owen8900/enclosure-watchdog/images/fig1_architecture.png

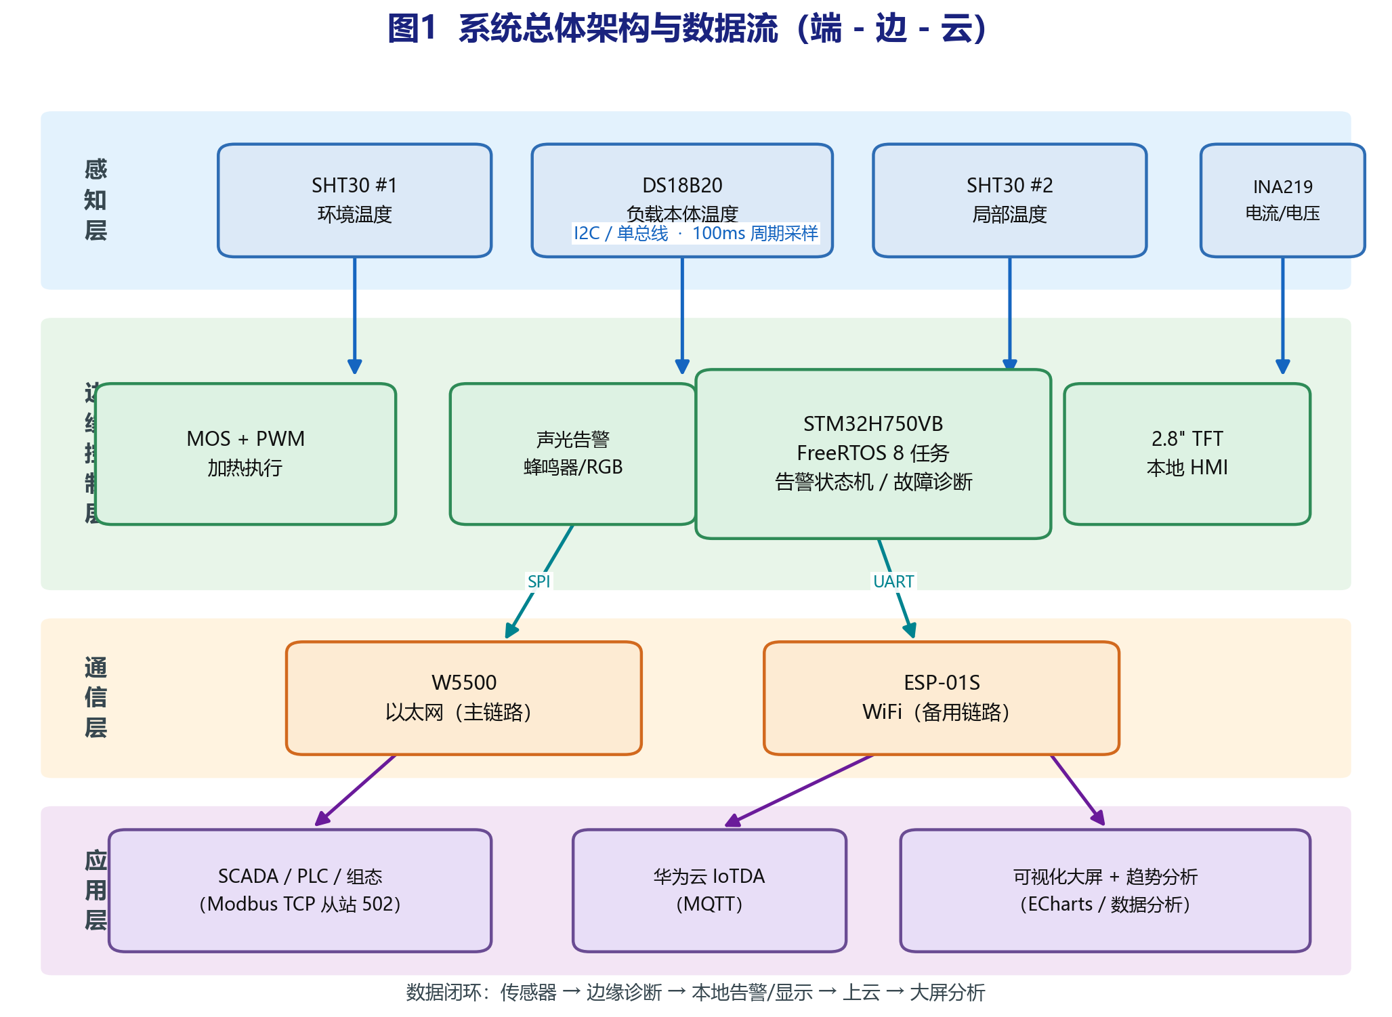
images/fig1_architecture.png
