owen8900/enclosure-watchdog/images/fig2_hardware.png

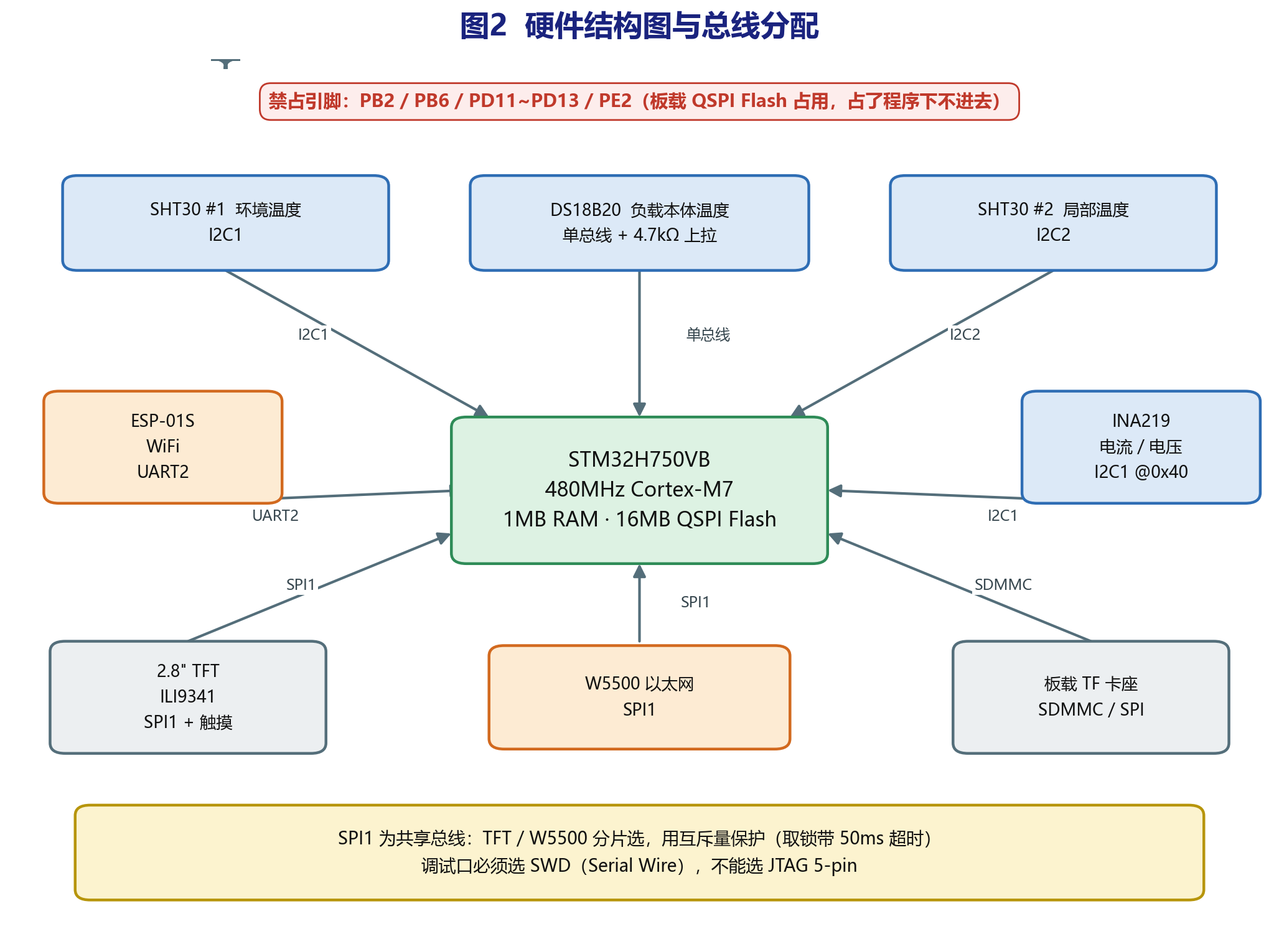
images/fig2_hardware.png
