owen8900/enclosure-watchdog/images/fig3_power.png

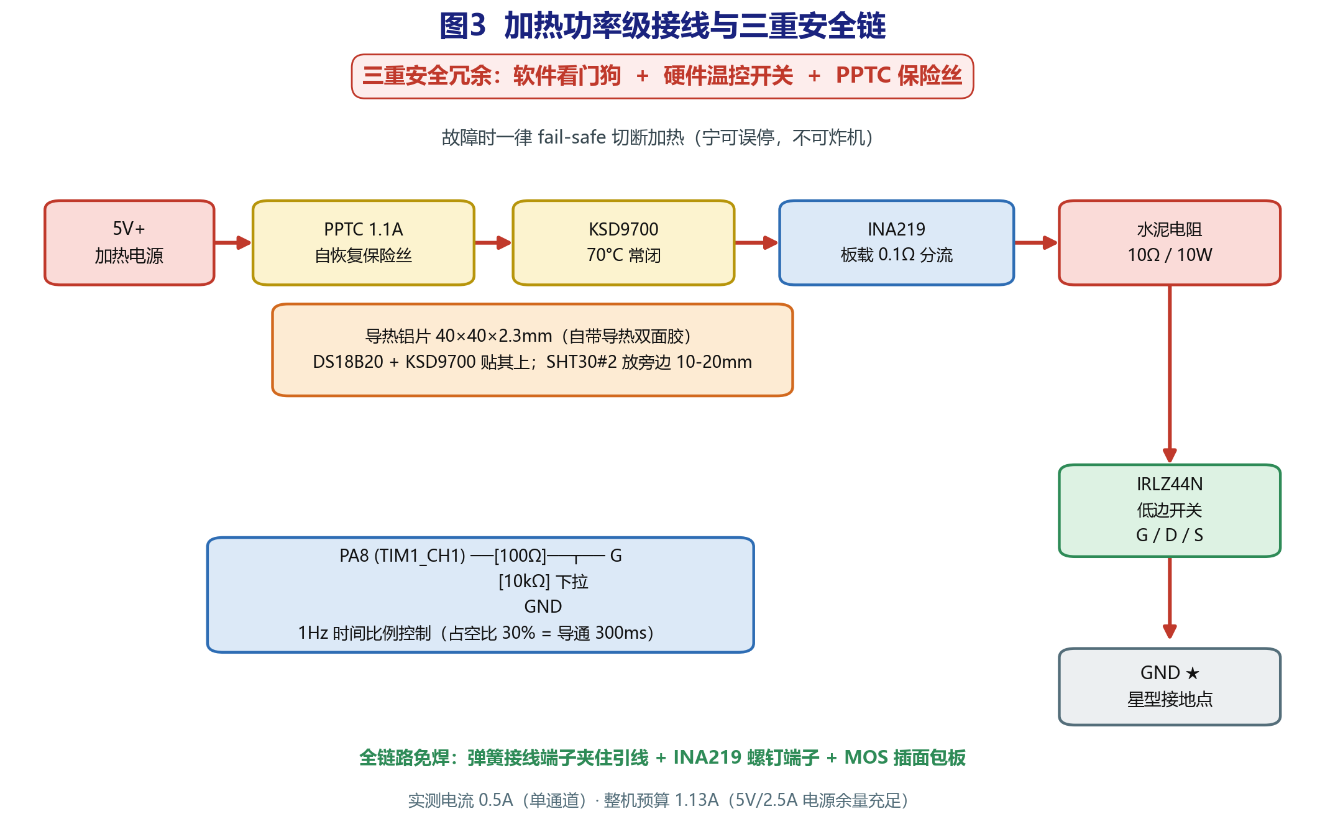
images/fig3_power.png
