owen8900/enclosure-watchdog/images/fig6_statemachine.png

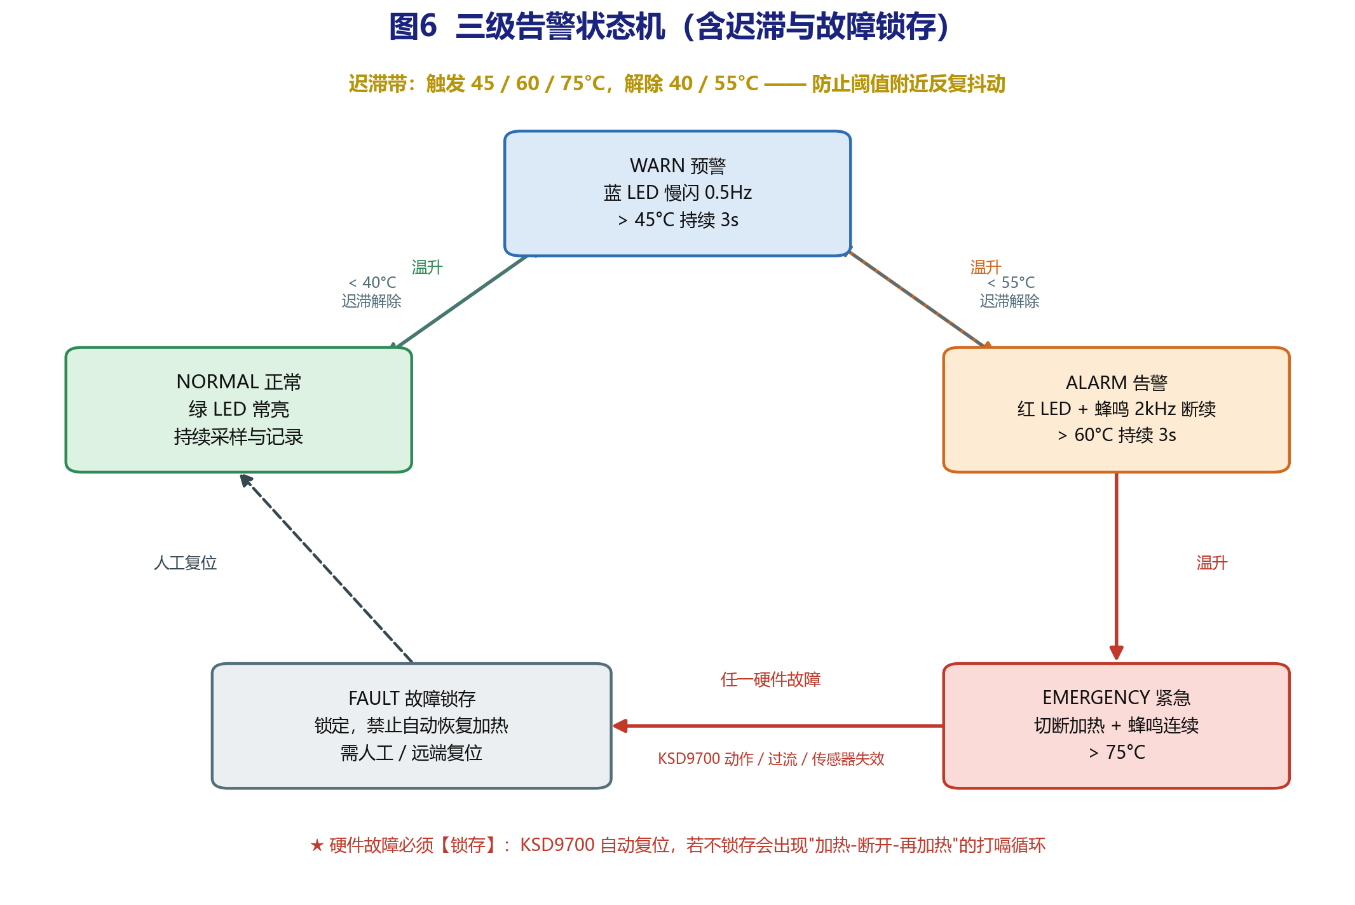
images/fig6_statemachine.png
