owen8900/enclosure-watchdog/images/fig12_integration.png

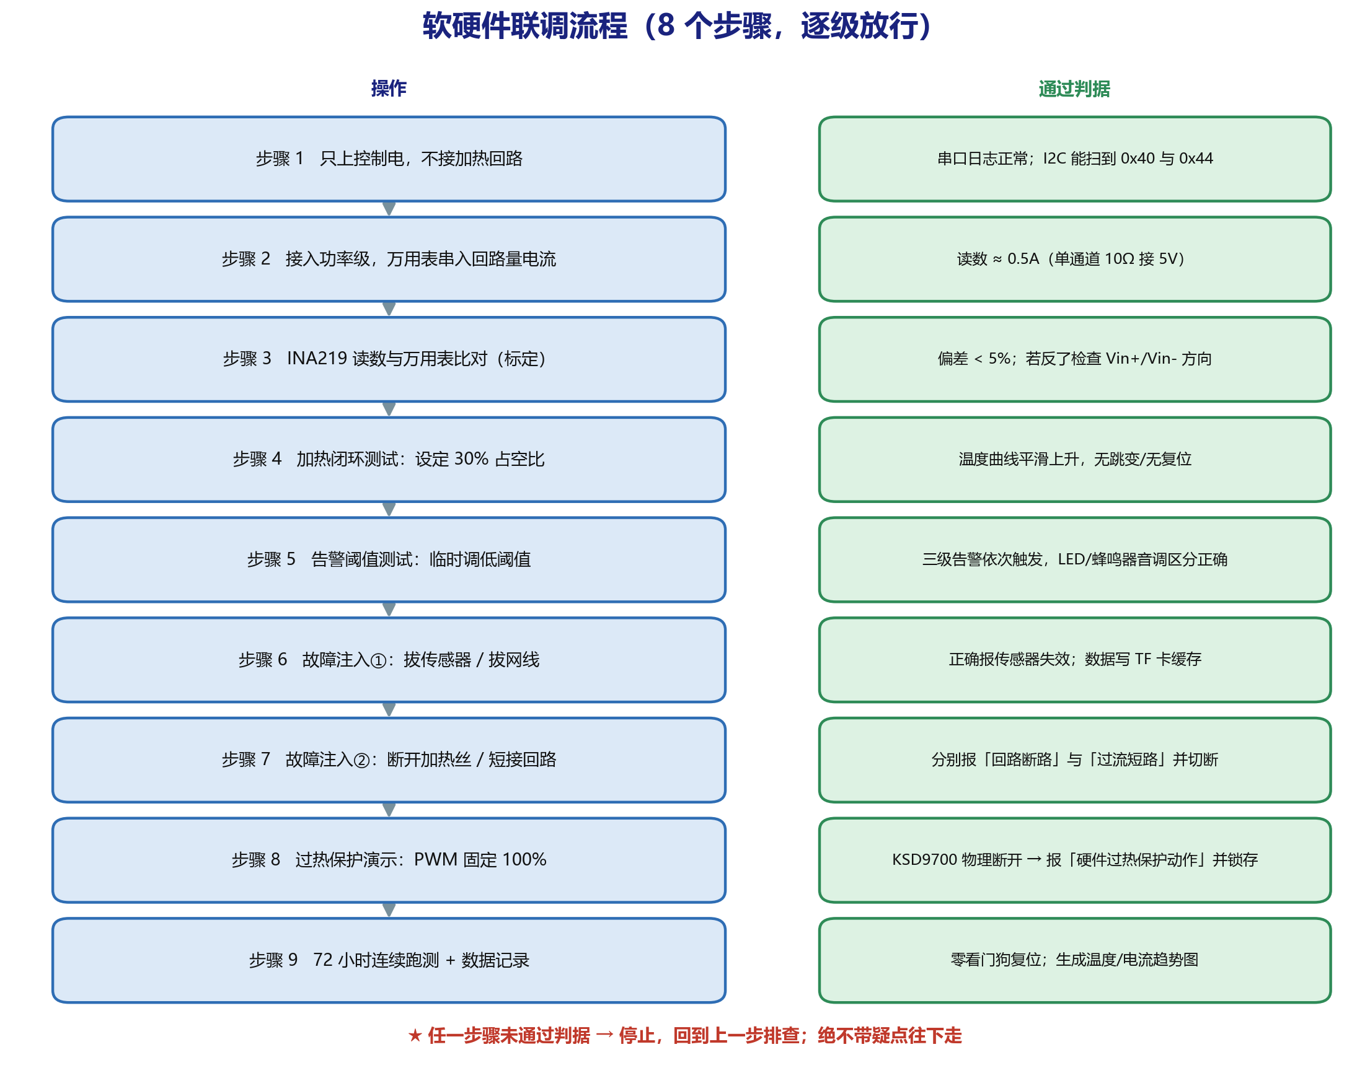
images/fig12_integration.png
