owen8900/enclosure-watchdog/images/fig4_steps.png

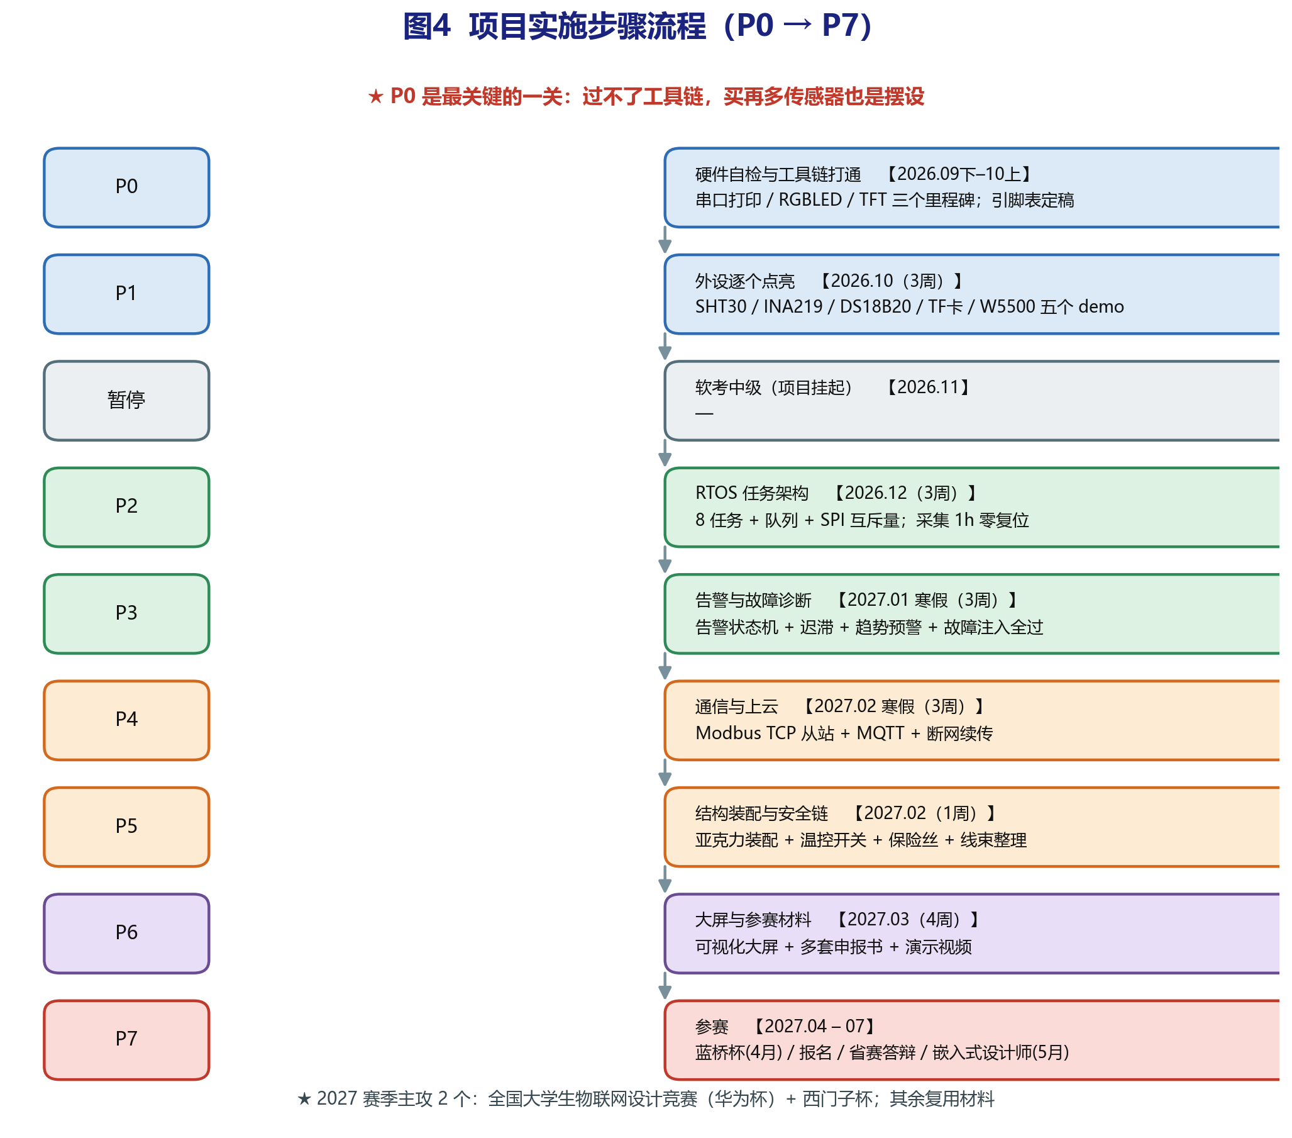
images/fig4_steps.png
