owen8900/enclosure-watchdog/code/Core/Inc/main.h

#define LED_B_Pin GPIO_PIN_5
#define LED_B_GPIO_Port GPIOE
#define LED_G_Pin GPIO_PIN_6
#define LED_G_GPIO_Port GPIOE
#define TOUCH_DO_Pin GPIO_PIN_0
#define TOUCH_DO_GPIO_Port GPIOC
#define TOUCH_CS_Pin GPIO_PIN_3
#define TOUCH_CS_GPIO_Port GPIOC
#define TOUCH_DIN_Pin GPIO_PIN_3
#define TOUCH_DIN_GPIO_Port GPIOA
#define TFT_CS_Pin GPIO_PIN_12
#define TFT_CS_GPIO_Port GPIOB
#define TOUCH_CLK_Pin GPIO_PIN_14
#define TOUCH_CLK_GPIO_Port GPIOB
#define LED_R_Pin GPIO_PIN_4
#define LED_R_GPIO_Port GPIOB
#define TFT_RST_Pin GPIO_PIN_0
#define TFT_RST_GPIO_Port GPIOE
#define TFT_DC_Pin GPIO_PIN_1
#define TFT_DC_GPIO_Port GPIOE
