owen8900/enclosure-watchdog/(commit log)

2026-09-13 初始提交：项目文档、硬件方案与核心算法（PC 端测试 11/11 通过）
2026-09-13 移除文档排版脚本
    这些脚本用来生成 Word 排版文档，不属于项目本体，生成的文档也已移出仓库。
    脚本本身保留在本地 notes/ 目录下，不入版本控制。
2026-09-13 图片改为中文命名，并挂载到对应文档
    原来的 fig1_architecture.png 这类命名不符合阅读习惯。
    改成按内容命名，例如 系统架构图.png、接线总览图.png，
    并在 README 和各篇设计文档里引用，避免图片成为无引用的孤儿文件。
2026-09-13 按开发板实测引脚分配表修正引脚方案
    之前是根据推导排的，拿到正点原子官方《MiniPro H750 V1 开发板 IO 引脚分配表》
    后逐条核对，改了八处：
    - 板载 I2C 从 PB8/PB9 改为 PB10/PB11（24C02 挂在这里，已有 4.7k 上拉）
    - DS18B20 改为 PC13（板载单总线接口，上拉已焊）
    - ESP-01S 从 PD5/PD6 改为 USART6 的 PC6/PC7（PD5/PD6 被 FMC 和触摸占用）
    - TFT 背光从 PB0 改为 PB5（板载 LCD 接口的 BL 脚）
    - 触摸片选从 PB1 改为 PC5，中断改为 PB1
    - 告警 LED 从 PC13 改为 PB12（PC13 让给 DS18B20）
    - QSPI 数据线更正：PD13 是 IO3，IO2 在 PE2
    引脚表加了「依据」一列，注明每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
2026-09-14 修正 RGB 灯引脚标注错误
    跑马灯例程 readme 和开发板 IO 引脚分配表都写明：
    RED(PB4) / GREEN(PE6) / BLUE(PE5)
    此前文档里写成了 绿=PE5、蓝=PE6，两色对调。
    共修正 9 个文件 12 处。
2026-09-14 按实测引脚分配表重绘接线总览图与引脚占用图
    出图脚本里的引脚数据和最新引脚表几乎全对不上，一并修正：
    - SHT30#1/INA219 由 PB8/PB9 改为 PB10/PB11（板载 I2C2，上拉已焊）
    - SHT30#2 由 PB10/PB11 改为 PB8/PB9（独立 I2C1）
    - DS18B20 由 PB12 改为 PC13（板载单总线接口）
    - ESP-01S 由 PD5/PD6 改为 PC6/PC7（USART6）
    - TFT 背光由 PB0 改为 PB5
    - 触摸 CS/IRQ 由 PB1/PC5 对调为 PC5/PB1
    - 告警 LED 由 PC13 改为 PB12
    - QSPI 数据线更正 PD13=IO3、PE2=IO2
    同时修复出图脚本的路径 bug：脚本位于 notes/tools/ 距仓库根两层，
    dirname 只用了两层，导致图片写到了 notes/images/ 而非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
2026-09-14 完成 P0a：CubeMX 工程生成 + 串口/GPIO 固件在板上跑通
    硬件：正点原子 MiniPro STM32H750 V1.5（片内 Flash 仅 128KB）
    工具链：Keil MDK 5.36 + STM32CubeMX 6.3.0 + 串口下载（无 ST-Link）
    分工：
    code/App/ 硬件无关的逻辑层（之前已完成，PC 端可测）
    code/Core/ CubeMX 生成 + 手写外设初始化与主循环
    code/Drivers/ HAL 驱动与 CMSIS
    code/MDK-ARM/ Keil 工程
    已实现的配置：
    时钟 HSE 8MHz -> PLL(M=4,N=480,P=2) -> SYSCLK 480MHz，VOS0
    AXI 240MHz / APB1-4 120MHz / APB 定时器时钟 240MHz
    串口 USART1 走 PA9/PA10，115200 8N1，接板载 CH340C
    灯 PB4/PE6/PE5 = RGB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
2026-09-14 完成 P0a-2：SDMMC1 挂载 SD 卡在板上跑通（SanDisk 16GB，实测 15193 MB）
    时钟（本次唯一改动的时钟树）：
    DIVQ1 由 /2 改 /5 -> PLL1Q 192MHz
    原因：PLL1Q 原为 480MHz，而 HAL 在识别卡时用的是编译时常数
    SDMMC_INIT_CLK_DIV=250，480/(2*250)=960kHz，超 SD 规范 400kHz 的 2.4 倍
    识别 SDMMC_CK = 192 / (2*250) = 384kHz 合规
    传输 SDMMC_CK = 192 / (2*4) = 24MHz 合规
    副作用：SPI1,2,3 内核时钟也随 PLL1Q 变为 192MHz（后续接 SPI 屏正好可用）
    外设：
    SDMMC1 四位宽总线，PC8/PC9/PC10/PC11 = D0~D3，PC12 = CK，PD2 = CMD（AF12）
    Clock Divider 填 4；不配 DMA —— H7 的 SDMMC 自带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
2026-09-14 完成 P0b-1：FATFS 挂载 SD 卡跑通（含写文件后读回比对），注释改中文
    实测输出（SanDisk 16GB，USART1 115200 8N1）：
    FATFS mount: OK
    SD card : OK type 1 (SDHC/SDXC) version 1 (SD 2.0)
    SD blockNbr: 31116288 blockSz 512 capacity 15193 MB
    SD class : 1461 (CSD 的 CCC 命令类位图，不是速度等级)
    FATFS free : 15189 MB (cluster = 64 扇区 = 32KB)
    FATFS dir : [FILE] CG_TEST.TXT
    FATFS write: 34 bytes -> CG_TEST.TXT
    FATFS read : OK, content matches (写完读回来逐字节比对一致)
    CubeMX 生成行为 —— 每次 GENERATE CODE 之后必查（已写进技能）：
    1. 使能 FATFS 后，CubeMX 把 HAL_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
2026-09-14 精简 main.c 注释：去掉装饰分隔符，压缩冗长说明
    改动内容：
    - 删掉装饰性的 /* ---- xxx ---- */ 包装，以及 /* ---- 第 N 步 ---- */ 的长破折号
    - M3 的成因说明从 15 行压到 5 行；其余注释逐条压缩到 1~2 行
    - 内联注释统一成 /* 红亮 */ 这种最小形式，不再做过对齐
    保留全部技术事实（这些是踩坑记录，删掉就白踩了）：
    - CubeMX 使能 FATFS 后会把 HAL_SD_Init() 从 MX_SDMMC1_SD_Init() 里删掉，
    卡改由 FATFS 的 BSP_SD_Init() 在首次 f_mount 时识别，所以卡信息必须挂载后再读
    - HAL_SD_GetCardInfo() 不填 CardSpeed，打印它会读到未初始化的栈内存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
2026-09-15 任务2 前半：u32_to_str + build_cycle_line 搬入 main.c，心跳行改由它们拼接（实板串口实测与改前逐字节相同，M3 自检全 OK）
2026-09-15 任务2 完成：心跳行追加写 SD 卡日志 LOG.TXT（实测每轮 +9/+10 字节 = 6+位数+2；cycle9 后 4729B、cycle10 后 4739B；开机自动 dump 文件头 200B，免读卡器验收）；打通 SWD 下载（ST-Link V2，IDCODE 0x6BA02477，BOOT0 永久留 GND）；uvprojx 被工具重排版（已核对 39 个文件一个没少、Star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
2026-09-15 更新 README：当前状态改为开发板已到位（P0a/P0b 实板验证通过）；新增硬件在环验证表；目录树按实际工程结构重写；显示选型改 2.8 寸 LCDWiki MSP2807；存储行标注轮转策略待做
2026-09-16 验证报告补上硬件在环部分，标题改为「验证报告」
    报告原先只覆盖算法层的 PC 端用例，上板之后这部分一直空着。这次把实板数据补进去：
    下载通道（串口与 SWD 两种）、上电自检的时钟实测、SD 卡与 FatFs 的完整串口输出、
    心跳日志落卡的每轮增量判据。心跳那段保留了一条对照实验——把打开模式换回
    FA_CREATE_ALWAYS，文件大小就不再随轮次累积，这条对照才是判定追加语义的依据。
    没验证的部分也一并列出：拔卡、写满、时序抗干扰。
2026-09-16 配上 SPI2 并挂好 2.8 寸 ILI9341 屏的引脚
    屏的接口定在 SPI2：PB13 时钟、PB15 数据，片选 PB12、复位 PE0、数据命令 PE1，
    三个控制脚的初始电平按"片选与复位常态高、数据命令常态低"设好。预分频取 32，
    SPI2 内核时钟 192MHz，实际 6MBits/s；Mode 0 与厂商例程一致。
    生成时还踩了一个坑：CubeMX 把 CMSIS 模板里的 startup_stm32h750xx.s 删掉了，
    Startup 组也一起消失，链接直接报 L6236E（分散加载文件里 RESET 段找不到向量表）。
    从 git 恢复该文件、把 Startup 组插回 uvprojx 之后编译通过，0 error 0 warning，
    Code=27830。
2026-09-16 接入 2.8 寸 ILI9341 SPI 屏，BSP 层驱动 + 上电刷色自检
    新增 code/Drivers/BSP/ili9341/。SPI1 的 PA5/PA6/PA7 没有引到 IO 排针上，改用 SPI2：
    信号走 PB13/PB15，片选 PB12、复位 PE0、数据命令 PE1。初始化序列照厂商 F429 例程
    的原值，只把 SPI 层换成 hspi2，寄存器值没有自己编。每次传输带 100ms 超时并累计
    失败次数，不留死等；发送缓冲 512 字节放静态区，不占栈。
    main.c 增加 M4 自检段：上电后红、绿、蓝各刷 0.4 秒，串口打印初始化状态与累计 SPI
    错误数。另外修了一起生成事故：CubeMX 这次把 main.c 里 41 行中文注释整段截断，从
    8a188c1 取回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
2026-09-16 屏不亮，加一个接线核对模式用万用表查线
    屏接上以后串口报 init OK、SPI 错误计数 0，屏却毫无反应。逐层排查：厂商例程的 SPI
    参数也是 Mode 0，spi.c 的 MspInit 里 PB13/PB15 的复用配置也对，那就只剩物理层。
    为此写了个不依赖调试器的核对模式：CS/RST/DC 依次 1Hz 翻转 8 秒，万用表直流档能
    直接看到 0V 与 3.3V 交替；SCK 与 MOSI 用持续发 0x00、0xFF 两轮区分，两轮里 SCK
    读数都约 1.6V，MOSI 则从 0V 跳到 3.3V。没有示波器也能把五根线对上。
    顺带加了日志回调：main.c 的 uart_puts 是 static，驱动调不到。核对模式由 main.c
    的 LCD_WIRING_TEST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
2026-09-16 屏点亮，关掉接线核对模式
    线的问题解决后不必每次上电都跑核对，改回 LCD_WIRING_TEST 0，省掉那 40 秒等待。
    核对函数留在驱动里，以后接触摸屏和 W5500 再碰到"SPI 报成功但设备不理人"，把宏
    打开就能用。
    本次根因是一根 SDI(MOSI) 杜邦线没插到底。数据线断了，时钟照跑、HAL 照返回 HAL_OK，
    屏收到的是乱码命令，所以串口一路正常、屏一动不动。排查过程记在 notes/13 §5.1。
2026-09-16 画控制柜面板界面，并压回 MDK-Lite 的 32KB 映像上限内
    新增 code/Drivers/BSP/lcd_font/（8x16 ASCII 字模 95 字，从厂商 FONT.H 的
    asc2_1608 原表抽出，未改动）与 code/Drivers/BSP/lcd_ui/（面板静态框架 +
    数据刷新）：标题栏、三行数值（温度/电流/电压，各带右侧状态色块）、中间一条
    总告警色条、底部状态行与自检行。数值暂用占位值，接上传感器后由调用方填入。
    ili9341 驱动补齐画线（Bresenham）、水平/垂直/空心矩形、字符与字符串绘制，
    字符支持 1~4 倍放大；越界或一行装不下就整体不画，直接返回。
    界面一进来就撞上免费版 Keil 的 3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
2026-09-16 XPT2046 触摸驱动：位翻转软件 SPI，编译通过，等上板验证
    模块上的触摸控制器和 ILI9341 本来是两条独立的 SPI（T_CLK/T_DIN/T_DO 与
    SCK/SDI/SDO 分开引出），所以没有并到 SPI2 上，而是用四条普通 GPIO 位翻转。
    理由是速率差得远：XPT2046 的 SCLK 上限约 2MHz，而 ILI9341 跑在 6MHz。合成一条
    总线的话，每读一次触摸都要先改 SPI2 分频、读完再改回来，等上 FreeRTOS 加互斥量
    时这类共享状态就是 bug 温床。位翻转只多占三个脚，互不干扰。
    引脚选的是左侧 IO 排针上、且官方 IO 分配表写「不插对应模块就完全独立」的几根：
    T_CS=PC3、T_CLK=PB14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
2026-09-16 切到 ARM Compiler 6：Community 许可不覆盖 AC5，32KB 上限随之解除
    社区版许可激活之后，工程还是链接失败，报的还是 L6047U（33512 字节超 32768）。
    查下来不是配置漏项，是许可范围问题：用户许可（User Based Licensing）只覆盖 AC6，
    AC5 用不了。三条证据：
    一、同一份超限代码，AC6 的链接器把 40978 字节的映像正常链出来（exit 0），
    AC5 的 armlink 对 41272 字节报 L6047U（exit 1）。
    二、armclang --version 自报 Product: Keil MDK Community；armcc 那边没有这句。
    三、armlm genLIC（从用户许可生成老式 LIC 的官方口子）明确拒绝，原文是
    "This license doe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
2026-09-16 屏左右镜像：MADCTL 补上 MX 位（0x08 -> 0x48）
    上板看界面时发现整屏的字是左右反的（"WARNING" 印成照镜子的样子）。
    上下方向是对的（标题栏在上面、状态行在下面），所以是纯水平镜像，不是 180° 旋转。
    MADCTL(0x36) 里有三位管方向：bit3 是 BGR 颜色顺序、bit6 是 MX（列地址反序）、
    bit7 是 MY（行地址反序）。厂商例程给的是 0x08，只开了 BGR —— 那是照他们手上
    那块玻璃的装配方向写的；我们这块实测要补 MX，也就是 0x48。初始化序列其余部分
    一个字节没动。
    顺带记一条：别顺手把 MY 也一起改，那会变成 180° 旋转，字上下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
2026-09-16 触摸标定改成「读数稳住就自己锁值」，一点一行不刷屏
    原来的自检每 200ms 打一行 raw X/Y，读数一直在跳 —— 手指在动、单次采样也有噪声，
    眼睛盯着跳数抄本来就取不准。
    改成标定向导（入口还是 xpt2046_selftest，main.c 里 XPT_SELFTEST_SECONDS 从 20
    调到 60，够点两轮）。四个点 LEFT/RIGHT/TOP/BOTTOM 依次点住：
    - 按下期间累计平均值和极值，满足任一条就捕获：
    (a) 采样 >= 6 且 X/Y 极差都 <= 48（读得干净，早捕获）
    (b) 采样 >= 16（约 800ms，多吵都捕获）
    第二条是关键：只按「稳住才捕获」的话，面板噪声一旦大于容差就永远等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
2026-09-16 标定汇总改掉一条会害人的提示：别拿空闲 X 去卡窗口
    欧文把串口日志发回来了（还是上一版的 raw X/Y 格式），数据把两件事钉死：
    一、判「按没按下」靠 Y —— 四百多行空闲记录里 Y 一直顶在 4095，一次例外都没有；
    按住时 Y 落在 245~3820。
    二、空闲时的 X 是乱跳的（178~790），而且跟「点左边」时的 X（180~230）重叠 ——
    所以 X 既不能单独用来判按下，也不能拿来卡窗口。
    原来汇总里那句「keep XPT2046_VALID_MIN/MAX outside this range」对着这种面板是错的：
    照它把窗口挤到空闲 X 范围之外，屏幕左边就被裁掉了。改成分开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
2026-09-16 触摸标定填上实测值，并加五点验收（固件自己判 PASS/FAIL）
    标定值来自点向导量的一轮。他点的是四个角（一个角同时给出 X 和 Y 的量程端点），
    每个角被独立测了两次，同一边两次相差 1~40 个数（约 1~3 像素），一致性好，取平均：
    x_raw_at_0 = 281 (左) x_raw_at_max = 3782 (右)
    y_raw_at_0 = 300 (上) y_raw_at_max = 3792 (下)
    swap_xy = 0
    顺手加了五点验收 xpt2046_verify()：点住左上、右上、左下、右下、正中，固件把原始值
    映射成像素坐标跟期望值比对，容差 12 像素，直接打 PASS/FAIL，最后给 n/5 结论。
    捕获判据跟标定向导共用（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
2026-09-16 修正标定：这块面板的 raw Y 与屏幕 Y 是反的（五点验收抓出来的）
    上一版刚填上标定值就去验收，五点里四个角全 FAIL，而且失败方式很整齐：
    [VERIFY 1/5] TOP-LEFT raw 196,3886 -> px 0,319 expect 0,0 FAIL
    [VERIFY 3/5] BOTTOM-LEFT raw 205,255 -> px 0,0 expect 0,319 FAIL
    点「左上角」映射成左下、点「左下角」映射成左上 —— 纯 Y 轴反向。
    根因是我上一轮推 Y 方向时推错了。那轮用的是 LEFT/RIGHT/TOP/BOTTOM 四点协议，
    而他四次的原始值里「TOP」和「BOTTOM」落在同一个 Y 上（3792 / 3791），
    说明那轮他没照提示点，我却按提示顺序去推上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
2026-09-16 主循环改成时间片调度，并加上触摸画点（① 验收用）
    原来主循环是整轮用 HAL_Delay 串起来的：光 RGB 三色就 0.9 秒，后面还有 SD 追加写
    和每 10 轮一次的面板刷新。手指按下去很可能正卡在延时里 —— 表现就是"触摸不灵、漏按"。
    改成每个动作各走各的周期，谁都不阻塞谁：
    LED 300ms
    触摸扫描 20ms <- 跟手的关键
    心跳日志 1000ms （原来约 0.9 秒一轮，等价）
    面板刷新 10000ms （原来每 10 轮，等价）
    顺带两件：
    - XPT_SELFTEST_SECONDS 改回 0。自检验收完了，正式固件不留这个阻塞段。
    注意：改回 0 之后两个向导（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
2026-09-16 触摸演示加原始值输出：定位"十字跟手指左右相反"到底出在哪一层
    反馈是十字跟手但左右相反。可五点验收用的是**同一套映射函数**（xpt_raw_to_px），
    方向真反了验收不可能 5/5 PASS —— 所以要么读数在这条路径上和验收路径不同，
    要么画的位置不对。这必须用数据分开，不能再靠猜。
    三处改动：
    - xpt2046_read_screen_fast() 多两个可选出参，顺便把原始值带出来。
    - 松手时往串口打一行 TOUCH px=.. py=.. raw=..,.. n=.. —— 不用拍照读屏，
    直接把日志文件发我就行，从 raw 和 px 的对应关系一看就知道是哪一层反了。
    - 开机把实际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
2026-09-16 显示方向可以当场循环切换（点屏幕最上面那一条），把"镜像"交给实测
    照片把真相摆出来了：不是触摸镜像，是**整幅画面转了 180°** —— 黄条上是 GNINRAW
    （WARNING 反着写）、状态行跑到最上面、标题蓝条跑到最下面、三个彩块跑到数值左边
    （代码里它们画在 x=200，是右边）。
    这件事暴露了我之前的一个盲区：**五点验收验的是"原始值 <-> 逻辑像素"，
    它永远验不出"逻辑像素在屏上朝哪个方向显示"** —— 显示方向和触摸标定是两个
    独立的自由度。标定是对的、显示方向是错的，验收照样 5/5 PASS。
    与其在这边猜 MADCTL，不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
2026-09-16 字模位序取反了 —— 这才是"字镜像"的根因，MADCTL 那条路是错的
    现象其实一直是两件不同的事，被我混成一件：
    A) 版面正常（标题栏在上、标签在左、彩块在右），只有**每个字母左右镜像**
    B) 字母正常，但**整幅版面左右镜像**（标题栏跑到右边、彩块跑到左边）
    离线把字模渲染出来比对，一次就定死了：lcd_font.c 来自厂商 FONT.H 的
    asc2_1608[95][16]，那份字库是**低位对应行内最左像素**；而 ili9341_draw_char
    按 0x80>>cx（高位在最左）取，于是每个字符都被左右镜像。渲染对照（L）：
    按 0x80>>cx：竖笔在右、脚朝左 ＝ 镜像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
2026-09-16 删掉显示方向循环切换那一套，注释压一遍
    方向已经定了（MADCTL 0x08，版面正、上下也正），点标题栏循环切四种的
    调试代码就没用了，整块删掉：ili9341 的 orient_next/get/madctl、
    main 里标题栏那个分支、开机那行 orient 打印。
    注释改成平时写代码的样子：不留历史过程和"别这么写"式的提醒，
    也不用 ==== / ---- 这类分隔线，一个函数一句说明就够了。
    逻辑没动。剥掉注释逐行比对，代码层差异就是删掉的那 46 行，
    其余 5 个文件代码层零差异。
    Keil 命令行重编 0 error 0 warning，Code=26616 RO-data=3700 RW-data=32 ZI-data=2744；
    最后一次纯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
2026-09-16 App 层注释也按同一标准压一遍
    和 BSP 那轮一个标准：一句话说明，不留调试过程和"别这么写"式的提醒，
    去掉 ==== / ---- / ----- 分隔线（六条判据那几块只去边框，条件和成因留着）。
    纯注释改动，剥掉注释逐行比对，9 个文件代码层零差异；
    WSL 里 gcc 编译跑核心算法验证，PASS = 11 FAIL = 0。
2026-09-16 触摸十字改成松手 250ms 后自己擦掉
    原来十字画上去就一直留着，拖一笔留一串。现在记下这一轮画过的所有十字的
    包围盒，松手 250ms 后先把包围盒涂黑，再把面板内容重画回去，盖住被涂掉的部分。
    没有用整屏重画：屏的 SDO(MISO) 没接线、读不回显存，本来只能靠重画来擦，
    但行距和底行右侧那些地方不在重画范围内（本来就该是黑的），只重画内容会留下红点。
    一次点按的包围盒才 9x9，比整屏清底（240x320，约 150ms）便宜得多。
    lcd_ui 拆出 ui_draw_frame()，新增 lcd_ui_repaint()：重画面板内容但不清屏。
    手还按着的时候不擦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
2026-09-17 触摸时钟脚加编译期开关：方案 A 就位
    W5500 要读回寄存器，必须用 SPI2 的 MISO；而 PB14 现在被触摸时钟占着
    （当初屏只写不读，MISO 用不上，才把它让给触摸、SPI2 的 MISO 映射到了 PC2）。
    新增 XPT_CLK_ON_PC2 开关：
    0（默认，维持现状）= 触摸时钟 PB14，SPI2_MISO 在 PC2
    1（方案 A） = 触摸时钟 PC2，PB14 还给 SPI2 当 MISO 给 W5500
    对调用运行时 GPIO 重映射完成，不动 CubeMX 生成的 spi.c / gpio.c，
    重跑 GENERATE CODE 也冲不掉。开关为 0 时重编的 hex 与上一版逐字节相同，
    所以板子现在不用重烧。
    三种状态都全量重编验证过：开关0 /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
2026-09-17 W5500 驱动 + 上电自检段（方案 A 生效）
    新增 Drivers/BSP/w5500/w5500.c/h：
    · 与屏共用 SPI2（SCK=PB13 / MOSI=PB15 / MISO=PB14），各用各的片选
    · 地址相位 3 字节 = addr[15:8] / addr[7:0] / (RWB<<7 | BSB)
    · 片选 SCS=PA8，由 w5500_init() 自己配成推挽输出（CubeMX 里没这个脚，
    运行时配置，重新 GENERATE CODE 也冲不掉）
    · 软复位（MR.RST）→ 读 VERSIONR，判据是固定值 0x04
    · 每次传输带 100ms 超时、失败计数，无动态分配、无无限阻塞
    main.c 加 M8 自检段：开机打印 VERSIONR / PHYCFGR / 链路状态，
    失败时把该查的 5 根线打出来。
    同时把 XPT_CLK_ON_PC2 翻到 1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
2026-09-17 w5500 驱动删掉没用上的日志钩子（KISS）
2026-09-17 W5500 自检加总线探针：让"读回 0x00"变得可判读
    实板第一次跑：SPI 一次没超时，但 VERSIONR 读回 0x00000000 —— 这是
    "时钟在跑、从机没应答"的形态，光看 0x00 分不出是没接、没电、被复位按住
    还是线接错。
    新增 w5500_bus_probe()：CS 拉低后连发 8 个 0xFF 当作读操作，把 MISO 上
    实际看到的字节带回来；自检失败时打印 OR / AND 并给结论：
    OR=0 → MISO 恒低（没接 / 模块没电 / 被拉低）
    AND=0xFF → MISO 恒高（没接 / 浮空）
    其它 → MISO 在跳，芯片活着，问题在别处
    同时确认了 PB14 在 V1.5 原理图上的复用功能表里确实有 S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
2026-09-17 工程文件跟 Keil 的写法对齐（删掉脚本多插的那个空行）
    _add_bsp_module.py 插 BSP 组时多留了一个空行，Keil 一打开工程就把它吃掉 ——
    结果每次编译 git status 都脏一次，会盖住真正的异常（比如启动文件被删）。
    脚本已改成不多留空行，工程文件按 Keil 的结果提交。
2026-09-17 W5500 自检加第二层探针（MISO 上拉电平）+ 编译期守卫
    第一层探针给出 MISO 恒低（OR=AND=0），但"恒低"还分两种：有东西主动拉低
    （线接错到 GND、模块没电被钳位），和线上压根没人（悬空恰好读到 0）。
    第二层：把 PB14 临时切成输入并开内部上拉读一次，读完还原成 AF5 ——
    上拉都拉不起来就是前者，拉得起来就是后者。
    另加编译期守卫：Plan A 要求 XPT_CLK_ON_PC2 == 1（触摸时钟让到 PC2，
    PB14 才能当 SPI2_MISO）。不满足直接 #error 停车，实测把开关翻成 0
    编不过（UV4 exit=2），免得编出一个 MISO 被触摸时钟占着的固件去插网线。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
2026-09-17 修 MISO 静态电平探针：切换引脚模式后要等上拉充起来再读
    40kΩ 内上拉给线容充电要几微秒，第一版切完立刻读，读到的其实是切换前的
    残留电平 —— 于是把悬空误读成被拉低，我据此怀疑线上有硬下拉。
    查原理图确认：PB14（网名 SPI2_MISO）上没有任何电阻。那颗 1K 的 R11 在
    相邻的 IRQ 线上（U2 无线座脚 8 那一行）。判据撤回。
    改成立刻读一次（fast，留着当证据）+ 等 2ms 再读一次（settled，这才是判据）。
2026-09-17 W5500 自检加位翻转慢速 SPI 探针（绕过 SPI2 外设）
2026-09-17 清掉注释里的中文引号（规范化脚本的规矩：字符串和引号里不放中文）
    位翻转探针的注释里写了一句 跟"被拉低"分开，那对引号是 ASCII 的，
    被 _normalize_bsp_files.py 的"行内引号配对且含非 ASCII"检查判 FAIL。
    改成不含引号的写法。
    顺便验证：只动注释，hex 应与上一版逐字节相同（说明没碰逻辑）。
2026-09-17 位翻转探针：把布尔参数的引脚切换拆成两个自解释函数
    bb_pin_mode(1u) / bb_pin_mode(0u) 这种调用点读不出意图（0 是"还给 SPI2"）。
    拆成 bb_pins_io() 和 bb_pins_af()，调用处一眼能看懂。
    还没烧过这版，所以趁现在改干净再让他烧，省一次烧录。
2026-09-18 主循环加 W5500 状态监视：值一变就打印
    排查接线时最烦的是"改一根线要按一次复位"。现在主循环每秒读一次
    VERSIONR，只在值变化时打一行：
    W5500 watch: VERSIONR=0x00000004 OK
    于是插着电、动着线，串口就能直接看出通没通，不用反复复位
    （复位还会把上一轮的现象冲掉）。正常运行时不打印，不刷屏。
    改动三处：TICK_W5500_MS 宏、t_w5 计时变量、主循环里的监视块。
    全量重编 0 error 0 warning；算法层 PASS=11 FAIL=0。
2026-09-18 W5500 探针做细：原样打探针字节 + 位翻转可读任意寄存器
    实板读数从"MISO 恒高"变成"MISO toggling"（OR=0xFF AND=0x00），说明这根线
    从"没人管"变成"时钟一打就有反应"。但 OR/AND 这种汇总分不出"芯片真在应答"
    和"悬空线拾到串扰"，所以：
    · 自检里把 8 个探针字节原样打出来（交替的 00/FF 像串扰，稳定的非零值像真数据）
    · 位翻转函数从只读 VERSIONR 改成可读任意寄存器，并加读 RTR
    （复位值 0x07D0）做交叉验证 —— 两个已知常量都对不上，说明地址相位根本没进去
    · 顺带加 uart_put_hex2（两位十六进制），原 uart_put_hex32 打 8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
2026-09-18 探针改发真正的 VERSIONR 读帧，读数不再有歧义
    原来发 8 个 0xFF，芯片会把它当成"地址 0xFFFF + BSB=0x1F 的读请求"，
    于是"前 3 字节是地址相位（从机不驱动 MISO）"和"对垃圾地址的应答"混在一起。
    实板读数 00 00 00 00 00 00 00 FF 就是这么来的，判不出芯片到底答没答。
    改成标准读帧：0x00 0x39 0x80（VERSIONR + 读位），后面补 0x00 把数据移出来。
    判据唯一：第 4 个字节 == 0x04 就是芯片正常应答。
    顺带删掉因此不再使用的 OR/AND 汇总（否则 any/all 变成赋值未用，
    项目要求 0 warning）。
    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
2026-09-18 修 W5500 帧格式控制字节：BSB 在 bit7:3、读写位在 bit2（原来整帧都是错的）
2026-09-18 W5500 监视加读数：错误计数 + SPI2 外设状态
    实板跑通自检验证了帧格式修复（VERSIONR 读到 0x04），但主循环第二次读
    回的是 0x00。而 w5500_read8() 传输失败时返回 0 —— "读失败"和"芯片回 0"
    在读数上分不开，是探针的问题不是结论。
    现在一起打 err（w5500 内部失败计数）和 hspi2.State：
    err 在涨 + State 不是 READY → SPI2 外设本身卡住了（多半被屏那边弄的）
    err 不动且 State 正常 → 那是真读到 0，要查芯片侧
    另外每 5 秒无条件打一行（原来只在变化时打，一直 0 就什么都不打，看不出趋势）。
    全量重编 0 error 0 warning；算法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
2026-09-18 W5500 双向跑通：静态 IP + socket0 UDP 收发，PC 与模块互相看得见
    网线直连 PC 网口（PC 侧设静态 192.168.1.100/24），板子上电后 PHYCFGR
    读 0xBF，链路 up。实测：模块每秒一包心跳，PC 的 UDP 调试助手连收 38 行；
    从 PC 发 20 字节，串口打出
    udp recv 20 B from 192.168.1.100:6000 [http://www.cmsoft.cn]
    同时 PC 侧收到原样回显的同一个包，两个方向都通，收包失败计数全程 0。
    驱动的收发顺序照 WIZnet 官方 ioLibrary 写的，三处容易漏的都在注释里标了：
    发送前先等 Sn_TX_FSR 腾出空间、写完数据自己加 Sn_TX_WR、发 SEND 之后轮询
    Sn_CR 等芯片清零再看 Sn_I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
2026-09-25 DS18B20 上板跑通：单总线位翻转驱动 + 开机自检 + 主循环读数
    板载单总线座（DQ=PC13）实测：温度每 2 秒一读，30.750 C 到 30.812 C 在变，
    是活读数不是定值；开机那行 device present 说明复位应答也对。
    驱动里三处值得留的：
    · PC13 由驱动自己在运行时配成开漏输出（和 W5500 片选同一手法），
    CubeMX 里配没配都不影响，重新 GENERATE CODE 也冲不掉
    · 微秒延时用 DWT 周期计数器，开机拿 HAL 的 1ms 时基标定一次，不依赖
    SystemCoreClock 有没有被更新过；DWT 万一没跑起来会退回有界粗糙延时，
    不会卡死在 while 里
    · 每个时隙内关中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
2026-09-25 修 DS18B20 的 ROM CRC 判据：对含 CRC 字节的 8 字节应当比 0
    上一版把判据写成 == rom[7]，也就是对含 CRC 的 8 字节算一遍 CRC 再去和它
    自己比，数学上恒不成立，于是 ROM 每次都报 CRC 错；而温度那条一直用的是
    残差式（!= 0），是对的 —— 等于把这个 bug 藏了两轮才被抓出来。
    实测（板载单总线座，DQ=PC13）：
    DS18B20: ROM=28BDA3587F250B44 (DS18B20)
    DS18B20: T=31.312 C（主循环每 2 秒一行，读数在 31.25~31.31 之间动）
    第一字节 28 认出型号、8 字节 CRC 通过。以后多只挂在同一条 1-Wire 总线上
    要靠 ROM 做匹配，所以这一步必须真通，不能只看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
2026-09-25 CubeMX 加 I2C2；顺带修掉生成时整块吞代码的结构性问题
    CubeMX 侧：Connectivity -> I2C2，Fast Mode，400kHz，PB10=SCL / PB11=SDA，
    参数落在 .ioc 里（I2C2.Timing=0x00B03FDB）。
    生成后照例的两处老毛病：startup_stm32h750xx.s 又被删（脚本修复）、
    ffconf.h 的 _USE_STRFUNC/_USE_MKFS 又被改回默认 2/1（退回原值，省几 KB Flash）。
    这次还暴露一个更严重的结构性问题：触摸那一整段（约 166 行）和主循环前的
    7 个计时变量，原先写在「USER CODE END 0 ~ BEGIN 1」和「USER CODE END 2 ~
    BEGIN WHILE」这两处缝隙里 —— 那片区域是 CubeMX 自己的地盘，重新生成时会被
    整块覆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
2026-09-25 I2C2 扫描器就位；日志工具收成一份共用件，并加一条"生成后自检"命令
    新增 Drivers/BSP/i2c_bus：扫 0x08~0x77（用 HAL_I2C_IsDeviceReady 逐地址探，
    每次探测带超时，空总线也能很快扫完）+ 收发原语，给后面的 SHT30/INA219 共用。
    main.c 的 M11 段开机扫一遍，主循环每 3 秒复扫，器件增删时才打印一行 —— 插一只
    报一只，接线时哪个模块没坐上总线当场就能看出来。
    顺手还掉一笔欠账：打数字/十六进制/定点小数这几个小工具，w5500.c 和 ds18b20.c
    里各复制了一份，I2C 这块本来会是第三份。抽成共用件 Drivers/BSP/common/bsp_log，
    模块不再各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
2026-09-25 把 CubeMX 生成后的自检脚本入库：scripts/post_generate.py
    放 scripts/ 而不是 tools/ —— tools/ 那条 .gitignore 是留给文档排版脚本的历史语义，
    不去抢它。脚本自包含（REPO 由自身位置推导），不依赖 notes/ 下的东西。
    它把"每次生成都会发生的那几件事"收成一条命令：启动文件被删、Startup 组丢失、
    ffconf.h 开关被改回默认、main.c 编码被写坏（坏了自己从 git 取回并把这次该加的
    include 与 MX_xxx_Init() 补回）、USER CODE 里的关键代码丢失、BSP 模块没挂进工程。
    幂等：健康工程上跑是空操作。
    用法：CubeMX 点完 GENERATE CODE 后
    python scripts\po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
2026-10-16 README 加徽章，顺手订正状态段和占用数字
    徽章六个，license / MCU / core / toolchain / language / 测试那行，写进去之前
    逐个 curl 过 HTTP 200 并核了 SVG 里的 aria-label。标题下面补一行 Gitee 和
    GitHub 的仓库链接。
    状态段还停在 9 月的 P0b，补上屏、触摸、W5500、DS18B20 四项实板验证，下一步
    从"屏驱动"改成 I2C 传感器。固件占用原来写的 27.5 KB 是旧版本，按 .map 的实际
    数字改成 38.3 KB Flash / 3.7 KB RAM。
2026-10-20 SHT30 驱动落地：单次测量 + 双 CRC8，挂进工程编译通过
    命令字和时延照 Sensirion SHT3x-DIS 手册 v7：0x2400 是高重复度且不开时钟
    拉伸，测量最长 15.5ms 所以等 20ms，读回 6 字节带两个 CRC8（多项式 0x31、
    初值 0xFF、不反射、末异或 0）。换算走定点，中间量用 int64 不会溢出。收发
    全走 i2c_bus 那套带超时的原语，失败只返回错误码并计数，不阻塞。
    验证分两段。算法段把 crc8() 和两条换算表达式从源码原样抽出来编到 PC 上跑：
    手册测例 CRC(0xBEEF)=0x92 对上，65536 个原始值跟浮点参考全量比对无差异，
    端点 -45.000°C / 130.000°C、0 %RH / 10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
2026-10-20 工程文件跟着 µVision 的写法入库，以后差异只剩真改动
    µVision 每次保存都把 .uvprojx 按它自己的序列化器重写：自闭合标签全展开成
    <X></X>、XML 声明变 standalone="no"，一次就冒 800 行噪音。原来的对策是每次
    还原再重插模块，太容易忘，而且一不留神就把噪音提交进去。
    这次直接以它的格式入库。等价性验了两遍：同一份源码用重排后的工程文件重建，
    hex 的 SHA256 跟还原版完全相同（a2caa050…5ef1），Keil 退出码 0。逐行看过
    diff，只有标签写法和空白变化，IncludePath、编译器、优化档、组名一个字没动，
    sht30 组和它的 include 路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
2026-10-20 README 状态段跟上进度：SHT30 已实板验证，下一步改成 #2 与 INA219
2026-10-20 把热模型参数的注释改成实情：初值估算，功率级接上后再辨识
    原来那两个 #define 的注释写着"实测辨识"，但功率级还没接、INA219 还没通，
    根本没有辨识的依据。这种话留在公开仓库里，懂行的人扫一眼就会发现，比写错
    参数更损伤可信度。
    改成"初值估算，功率级接上后辨识"，辨识方法那段保留（描述方法本身没问题）。
    纯注释改动，重建后 hex 的 SHA256 与改前相同（a2caa050…5ef1），已烧的板子不用重烧。
